hsrascon/Arduino-Electronic-Load-/README.md

# Arduino-Electronic-Load-
An electronic load in constant current mode using the Arduino
