hsrascon/Arduino-Electronic-Load-/Portfolio/4.-Presentation/Arduino Electronic Load_V05.pptx

## Arduino Electronic Load

Habid Rascon-Ramos

## Arduino Electronic Load Review

- Overview and Goals
- Hardware Development Process
- Final Product
- Results

## Overview

- Electronic Load
- Development tool
  - Power supply and battery testing
- Current commercial options
  - Too expensive and overpowered

## Goals

- Open source
- Cater to maker market
- Make it programmable using Arduino
- Deliverable: The load can maintain a 1A current draw for 1 hour at 5% accuracy

## Product Definition: Feature Block Diagram

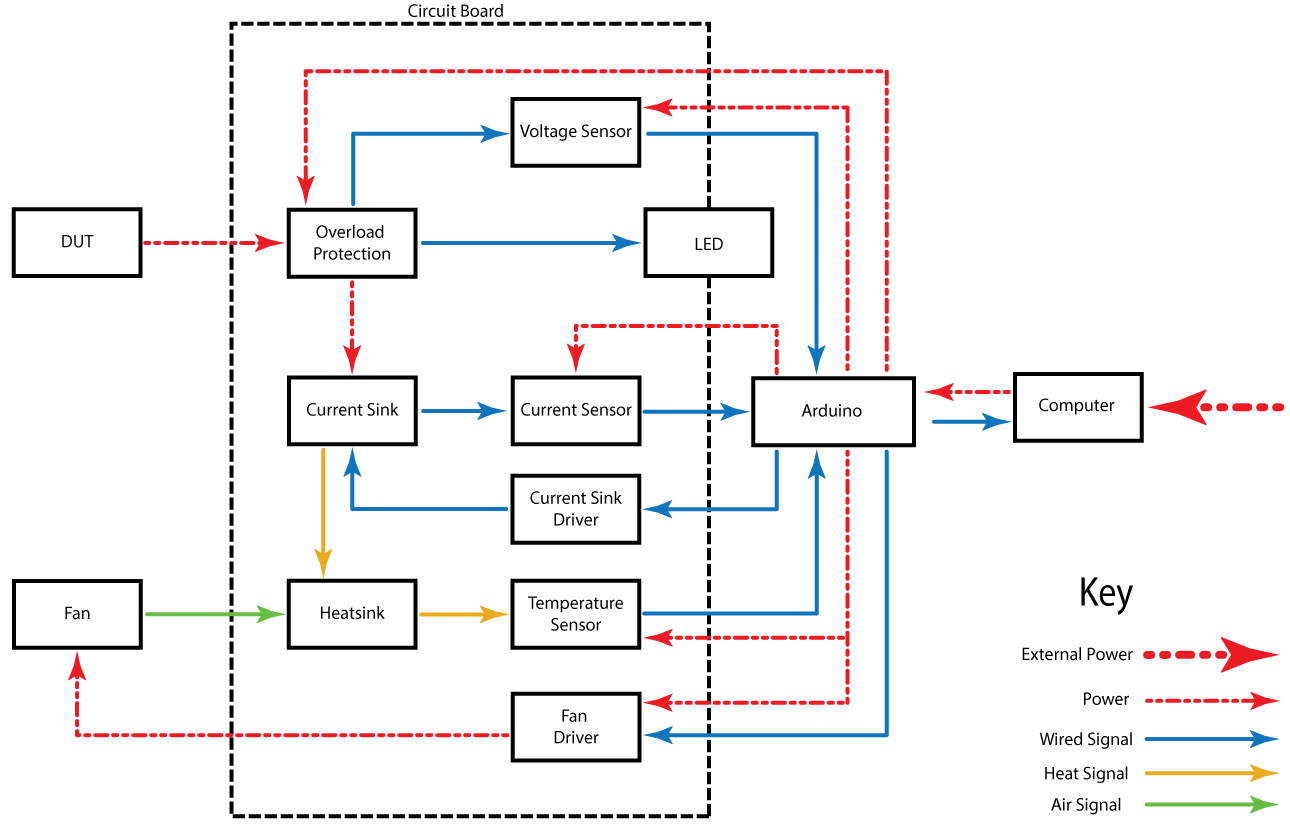
[picture p1: figure]

## Product Definition: State Machine Flow Diagram

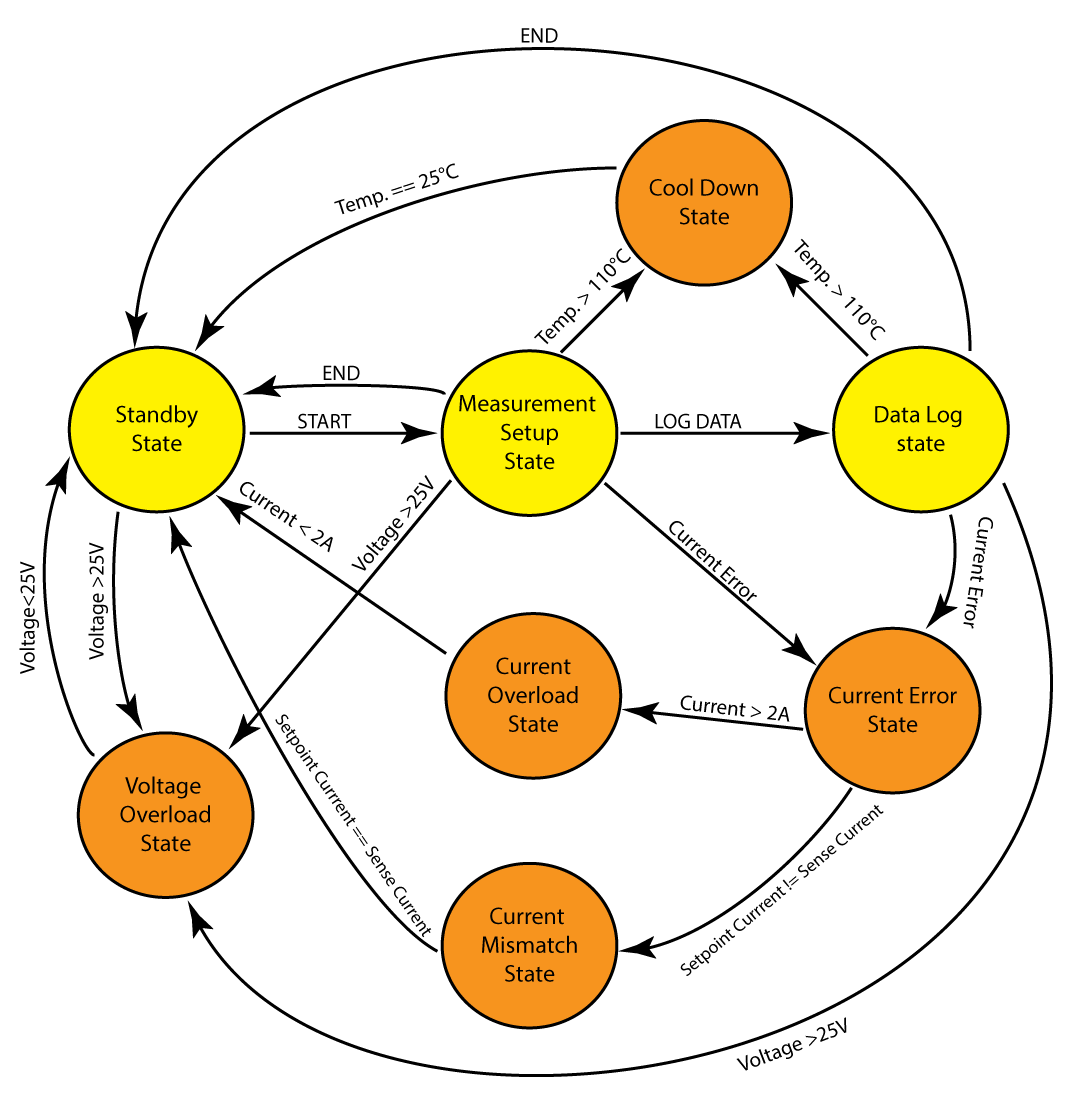
[picture p2: figure]

## Architecture: Hardware Block Diagram

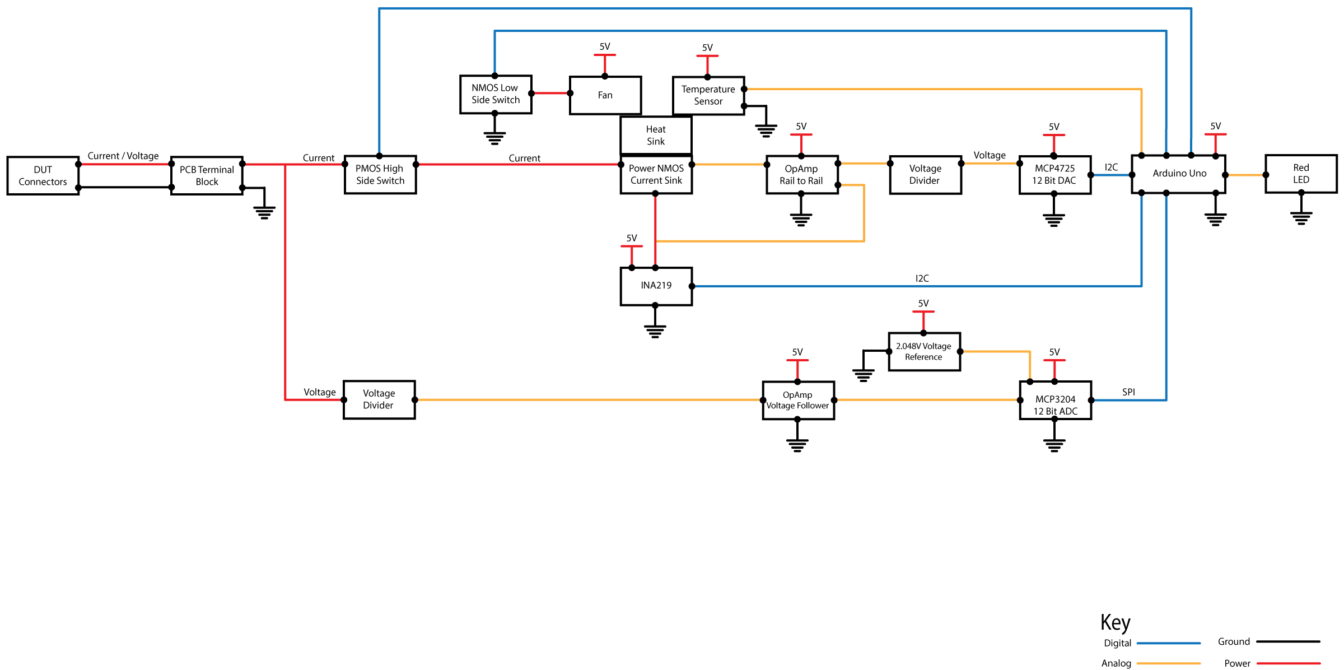
[picture p3: figure]

## Realization: PCB Schematic

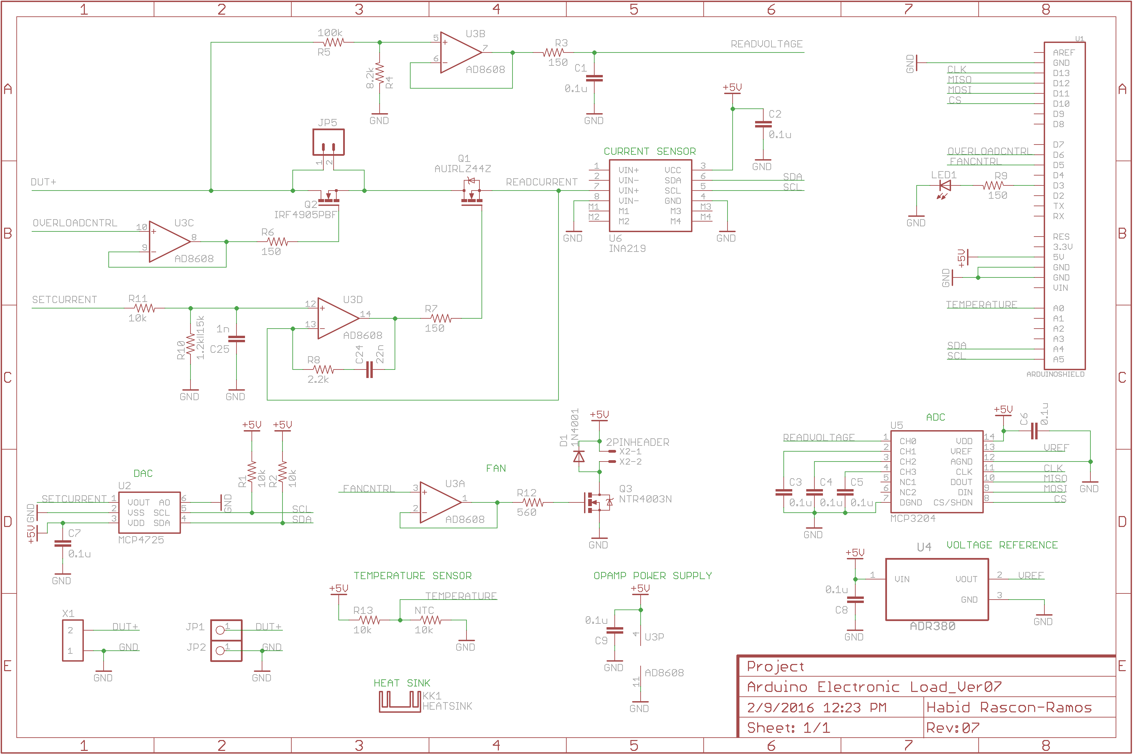
[picture p4: figure]

## Realization: PCB Layout

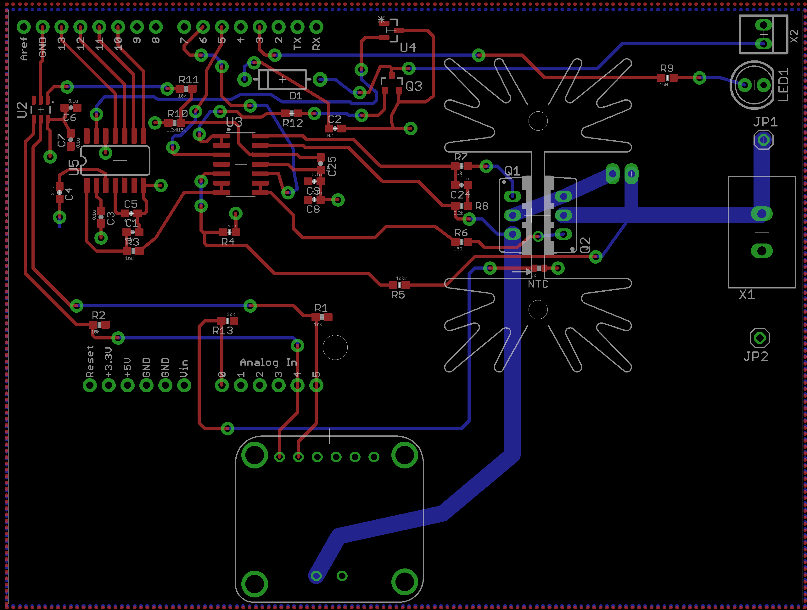
[picture p5: figure]

## Final Product: Hardware

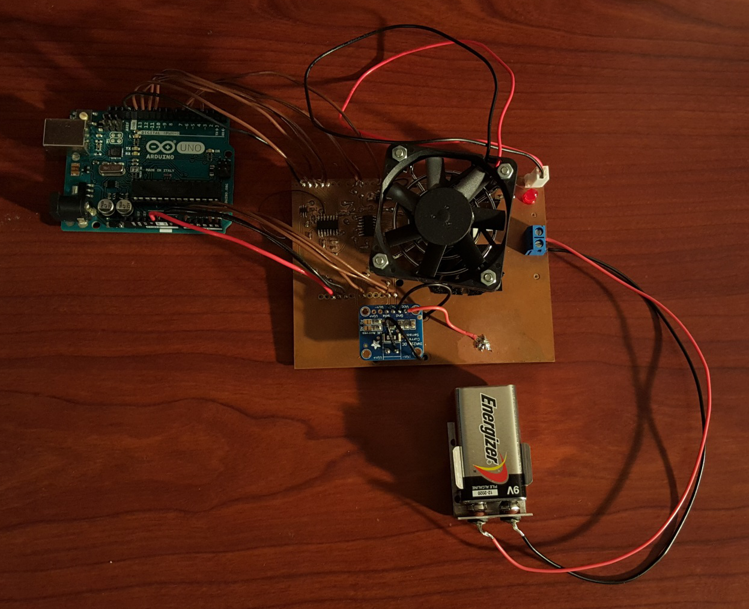
[picture p6: figure]

## Final Product: Software

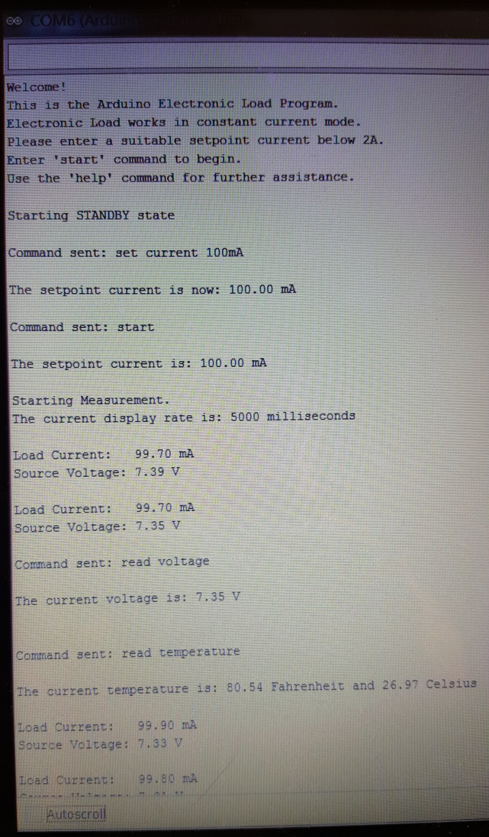
[picture p7: figure]

## Results: Constant Current Test

## Results: 9V Battery Test
