hsrascon/Arduino-Electronic-Load-/Portfolio/1.-Product-Definition/ArduinoELoad_FeatureDiagram_V07.pdf

## Key

Power

Wired Signal

External Power

## Version 07

## Arduino Electronic Load Feature Block Diagram

Heat Signal
Air Signal

Introduction:
This diagram shows the relationship between the dierent blocks that appear in the Feature List. The dashed line represents a device boundary. An interface will need to be dened for any signal that crosses the boundary. Blocks that touch the boundary are access able from the outside of the device

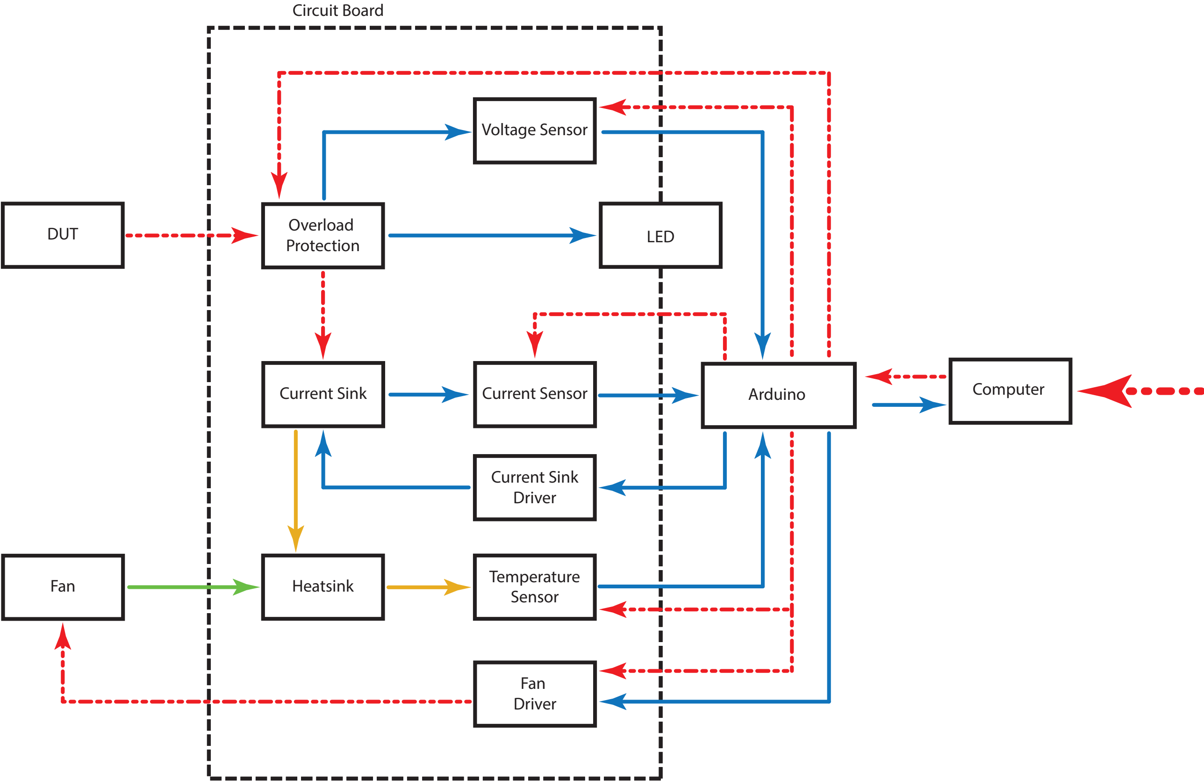
[picture p8: figure]
Voltage Sensor; Current Sensor; Arduino; Circuit Board; Current Sink Driver; Current Sink; Computer; Overload Protection; Temperature Sensor; DUT; LED; Heatsink; Fan Driver; Fan
