hsrascon/Arduino-Electronic-Load-/Portfolio/3.-Realization/ManufacturingPackage/ArduinoElectronicLoad_FullBOM.xlsx

Author: Habid Rascon-Ramos
Date: February 11, 2016
Project: Arduino Electronic Load
Version: 01
Qty | Value | Device | Package | Parts | Description | DESCRIPTION | MANUFACTURER | MFG_PART_NUMBER | PACKAGE | VENDOR | VENDOR_PART_NUM
9 | 0.1u | CAP0603-CAP | 0603-CAP | C1, C2, C3, C4, C5, C6, C7, C8, C9 | Capacitor | CAP CER 0.1UF 16V X7R 0603 | Murata Electronics North America | GRM188R71C104KA01D | 603 | Digi-Key | 490-1532-1-ND
1 | 1.1k | RESISTOR0603-RES | 0603-RES | R10 | Resistor | RES SMD 1.1K OHM 1% 1/10W 0603 | Yageo | RC0603FR-071K1L | 603 | Digi-Key | 311-1.10KHRCT-ND
1 | 100k | RESISTOR0603-RES | 0603-RES | R5 | Resistor | RES SMD 100K OHM 1% 1/10W 0603 | Yageo | RC0603FR-07100KL | 603 | Digi-Key | 311-100KHRCT-ND
1 | 10k | RESISTOR0402-RES | 0402-RES | NTC | Resistor | THERMISTOR 10K OHM NTC 0402 SMD | Murata Electronics North America | NCP15XH103F03RC | 402 | Digi-Key | 490-4801-1-ND
4 | 10k | RESISTOR0603-RES | 0603-RES | R1, R2, R11, R13 | Resistor | RES SMD 10K OHM 1% 1/10W 0603 | Yageo | RC0603FR-0710KL | 603 | Digi-Key | 311-10.0KHRCT-ND
4 | 150 | RESISTOR0603-RES | 0603-RES | R3, R6, R7, R9 | Resistor | RES SMD 150 OHM 1% 1/10W 0603 | Yageo | RC0603FR-07150RL | 603 | Digi-Key | 311-150HRCT-ND
1 | 1N4001 | DIODEPTH | DIODE-1N4001 | D1 | Diode | DIODE GEN PURP 50V 1A DO41 | Fairchild Semiconductor | 1N4001 | DO-41 | Digi-Key | 1N4001FSCT-ND
1 | 1n | CAP0603-CAP | 0603-CAP | C25 | Capacitor | CAP CER 1000PF 50V X7R 0603 | Murata Electronics North America | GRM188R71H102KA01D | 603 | Digi-Key | 490-1494-1-ND
1 | 2.2k | RESISTOR0603-RES | 0603-RES | R8 | Resistor | RES SMD 2.2K OHM 1% 1/10W 0603 | Yageo | RC0603FR-072K2L | 603 | Digi-Key | 311-2.20KHRCT-ND
1 | 22232021 | CON-MOLEX_22-23-2021 | CON-MOLEX_22-23-2021 | X2 | .100 (2.54mm) Center Header - 2 Pin" | CONN HEADER 2POS .100 VERT TIN | Molex, LLC | 22232021 | N/A | Digi-Key | WM4200-ND
1 | 22n | CAP0603-CAP | 0603-CAP | C24 | Capacitor | CAP CER 0.022UF 16V X7R 0603 | Murata Electronics North America | GRM188R71C223KA01D | 603 | Digi-Key | 490-1527-1-ND
1 | 560 | RESISTOR0603-RES | 0603-RES | R12 | Resistor | RES SMD 560 OHM 1% 1/10W 0603 | Yageo | RC0603FR-07560RL | 603 | Digi-Key | 311-560HRCT-ND
1 | 8.2k | RESISTOR0603-RES | 0603-RES | R4 | Resistor | RES SMD 8.2K OHM 1% 1/10W 0603 | Yageo | RC0603FR-078K2L | 603 | Digi-Key | 311-8.20KHRCT-ND
1 | 961102-6404-AR | M02 | 1X02_LONGPADS | JP5 | Header 2 | CONN HEADER VERT SGL 2POS GOLD | 3M | 961102-6404-AR | N/A | Digi-Key | 3M9447-ND
1 | AD8608 | AD8608R | SO14 | U3 | Precision, Low Noise, CMOS, Rail-to-Rail, Input/Output Operational Amplifiers | IC OPAMP GP 10MHZ RRO 14TSSOP | Analog Devices Inc. | AD8608ARUZ-REEL | 14-TSSOP | Digi-Key | AD8608ARUZ-REELTR-ND
1 | ADR380 | ADR380ARTZ-REEL7 | SOT95P237X112-3N | U4 | Precision Low Drift 2.048 V/2.500 V SOT-23 Voltage Reference | IC VREF SERIES 2.048V SOT23-3 | Analog Devices Inc. | ADR380ARTZ-REEL7 | SOT-23-3 | Digi-Key | ADR380ARTZ-REEL7CT-ND
1 | AUIRLZ44Z | IRLZ44Z | TO220BV_1 | Q1 | N-Channel HEXFET® Power MOSFET Logic Level | MOSFET Transistor, N Channel, 51 A, 55 V, TO-220AB | INTERNATIONAL RECTIFIER | AUIRLZ44Z | TO-220AB | Newark | 54T9019
1 | INA219 | INA219 | INA219 | U6 |  | BREAKOUT INA219 DC SENS 26V 3.2A | Adafruit Industries LLC | 904 | N/A | Digi-Key | 1528-1168-ND
1 | IRF4905PBF | PMOSFET_NTO220BV | TO220BV | Q2 | Power MOSFET N-Channel | MOSFET P-CH 55V 74A TO-220AB | Infineon Technologies Americas Corp. | IRF4905PBF | TO-220AB | Digi-Key | IRF4905PBF-ND
1 | LTL2R3KRD-EM | LED5MM | LED5MM | LED1 | LEDs | LED RED DIFF 5MM ROUND T/H | Lite-On Inc. | LTL2R3KRD-EM | Radial | Digi-Key | 160-1853-ND
1 | MCP3204 | MCP3204CRZ | SOIC-14 | U5 | IC ADC 12BIT 2.7V 4CH SPI 14SOIC | IC ADC 12BIT 2.7V 4CH SPI 14SOIC | Microchip Technology | MCP3204-CI/SL | 14-SOIC | Digi-Key | MCP3204-CI/SL-ND
1 | MCP4725 | MCP4725SOT-23 | SOT23-6 | U2 | Microchip 12-bit I2C DAC, SOT23-6 | IC DAC 12BIT W/I2C SOT23A-6 | Microchip Technology | MCP4725A0T-E/CH | SOT-23-6 | Digi-Key | MCP4725A0T-E/CHCT-ND
1 | NTR4003N | MOSFET-NCHANNELAO3404A | SOT23-3 | Q3 | Common NMOSFET Parts | MOSFET N-CH 30V 500MA SOT-23 | ON Semiconductor | NTR4003NT1G | SOT-23-3 | Digi-Key | NTR4003NT1GOSCT-ND
1 | OSTTC022162 | ED350/2 | ED350/2 | X1 | ED350/X (5.0 mm) TERMINAL BLOCK 5MM VERT 2POS PCB | TERM BLOCK 5.08MM VERT 2POS PCB | On Shore Technology Inc. | OSTTC022162 | N/A | Digi-Key | ED2609-ND
1 | SK 129 25,4 STS | HEATSINK_SK129 | HEATSINK_SK129-HOLE | KK1 | HEATSINK manufacturer Fischer/distributor Buerklin | HEAT SINK, EXTRUDED, PCB MOUNT | FISCHER ELEKTRONIK | SK 129 25,4 STS | N/A | Newark | 74M4513
1 | EB50100S2-0000-999 | N/A | N/A | N/A | N/A | FAN, 50X50X10MM, 5VDC | SUNON | EB50100S2-0000-999 | N/A | Newark | 58T4647
