hsrascon/Arduino-Electronic-Load-/Portfolio/2.-Architecture/ArduinoELoadHardwareBlockDiagram_V06.pdf

# Arduino Electronic Load Hardware Block Diagram V06

## Introduction:

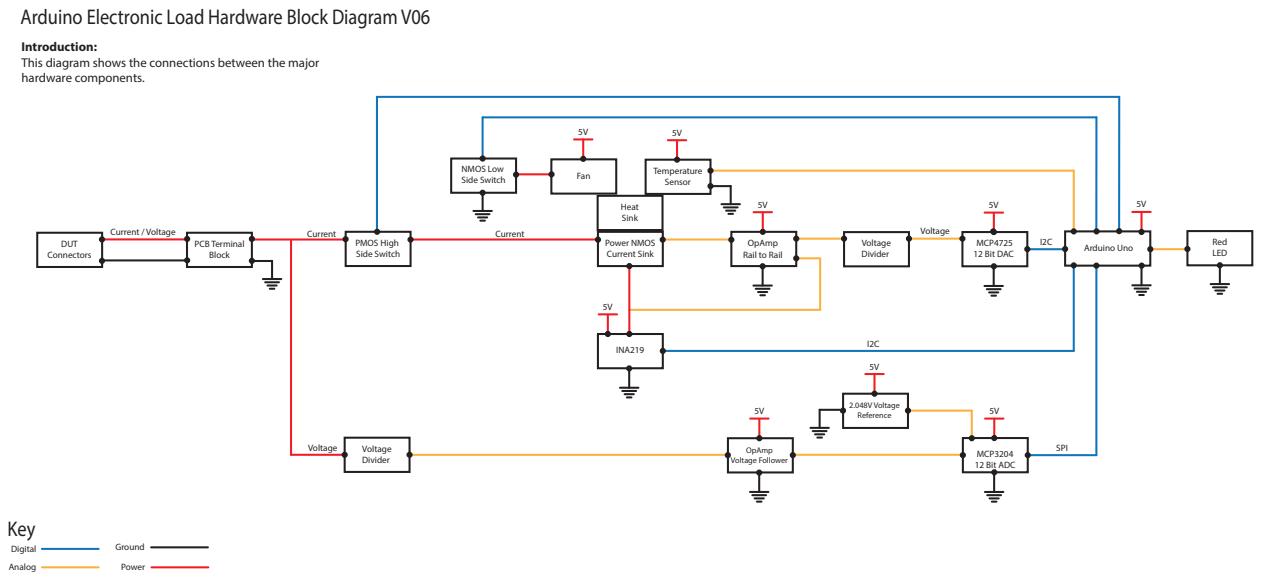
[picture p9: page 1]
Red LED; PCB Terminal Block; Key; Digital; Power; Ground; Analog; DUT Connectors; Current / Voltage; Heat Sink; Temperature Sensor; Current; Voltage; Voltage Divider; MCP4725 12 Bit DAC; OpAmp Voltage Follower; Fan; NMOS Low Side Switch; PMOS High Side Switch; Power NMOS Current Sink; INA219; Arduino Uno; MCP3204 12 Bit ADC; 2.048V Voltage Reference; SPI

This diagram shows the connections between the major
hardware components.

OpAmp
Rail to Rail
