hsrascon/Arduino-Electronic-Load-/Portfolio/1.-Product-Definition/ArduinoELoad_StateMachine_V01.pdf

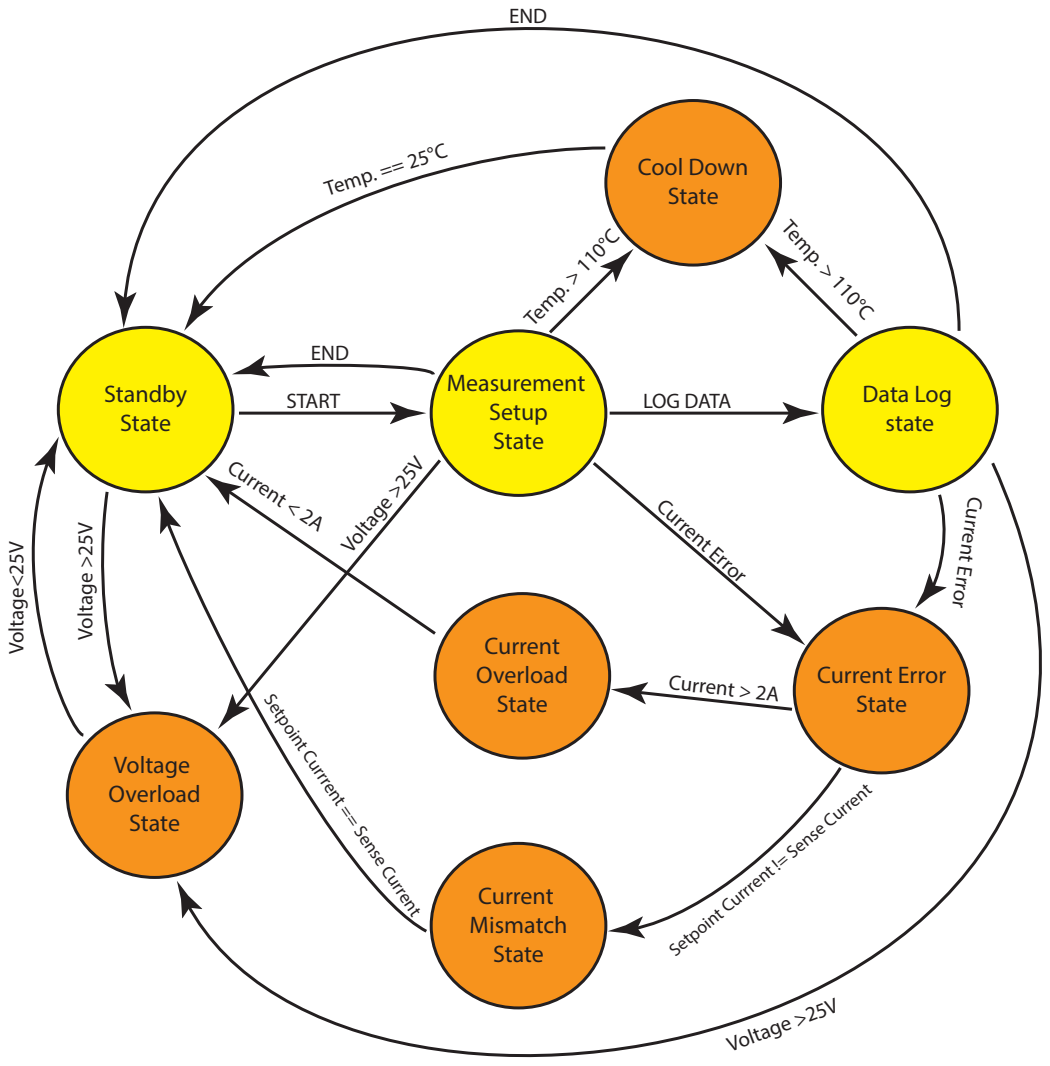
[picture p10: page 1]
Standby State; Measurement Setup State; Data Log state; Voltage Overload State; Current Error State; Cool Down State; Current Mismatch State; Current Overload State; START; Voltage >25V; Current Error; Temp. > 110°C; LOG DATA; END; Voltage<25V; Current < 2A; Current > 2A; Temp. == 25°C

Setpoint Currrent == Sense Current

Setpoint Currrent != Sense Current
