hsrascon/Arduino-Electronic-Load-/Portfolio/3.-Realization/Board/ArduinoELoad_Layout_V08.pdf

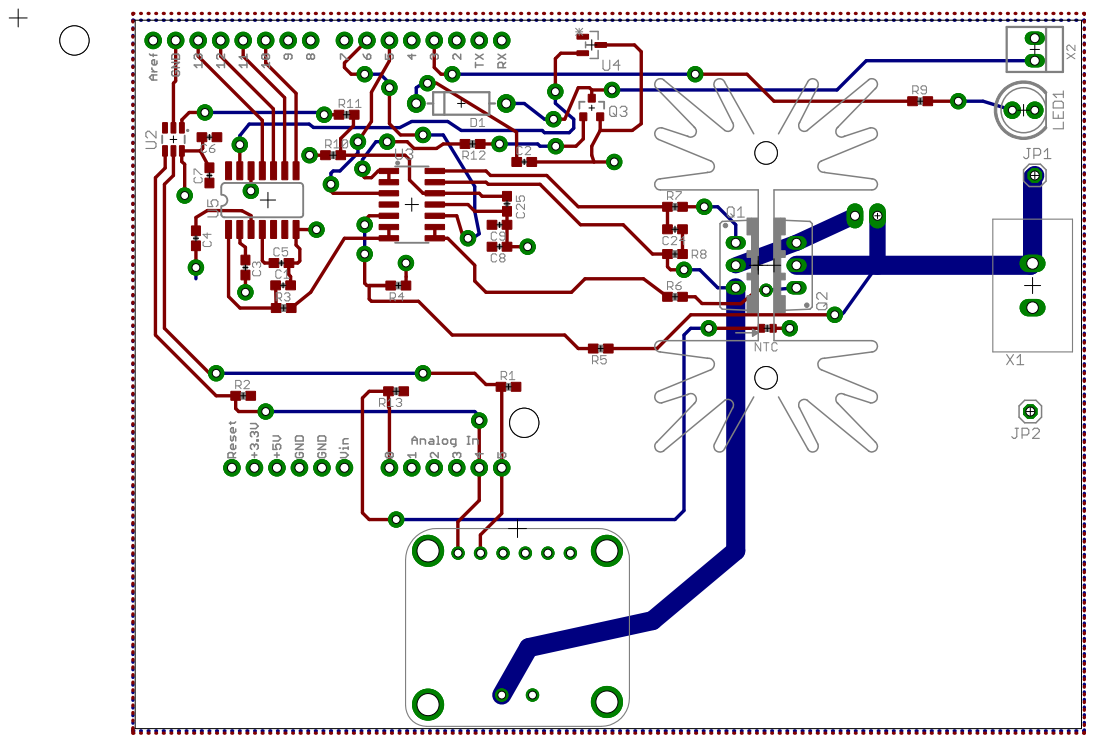
[picture p11: page 1]
