hsrascon/Arduino-Electronic-Load-/Portfolio/3.-Realization/Board/ArduinoELoad_Schematic_V08.pdf

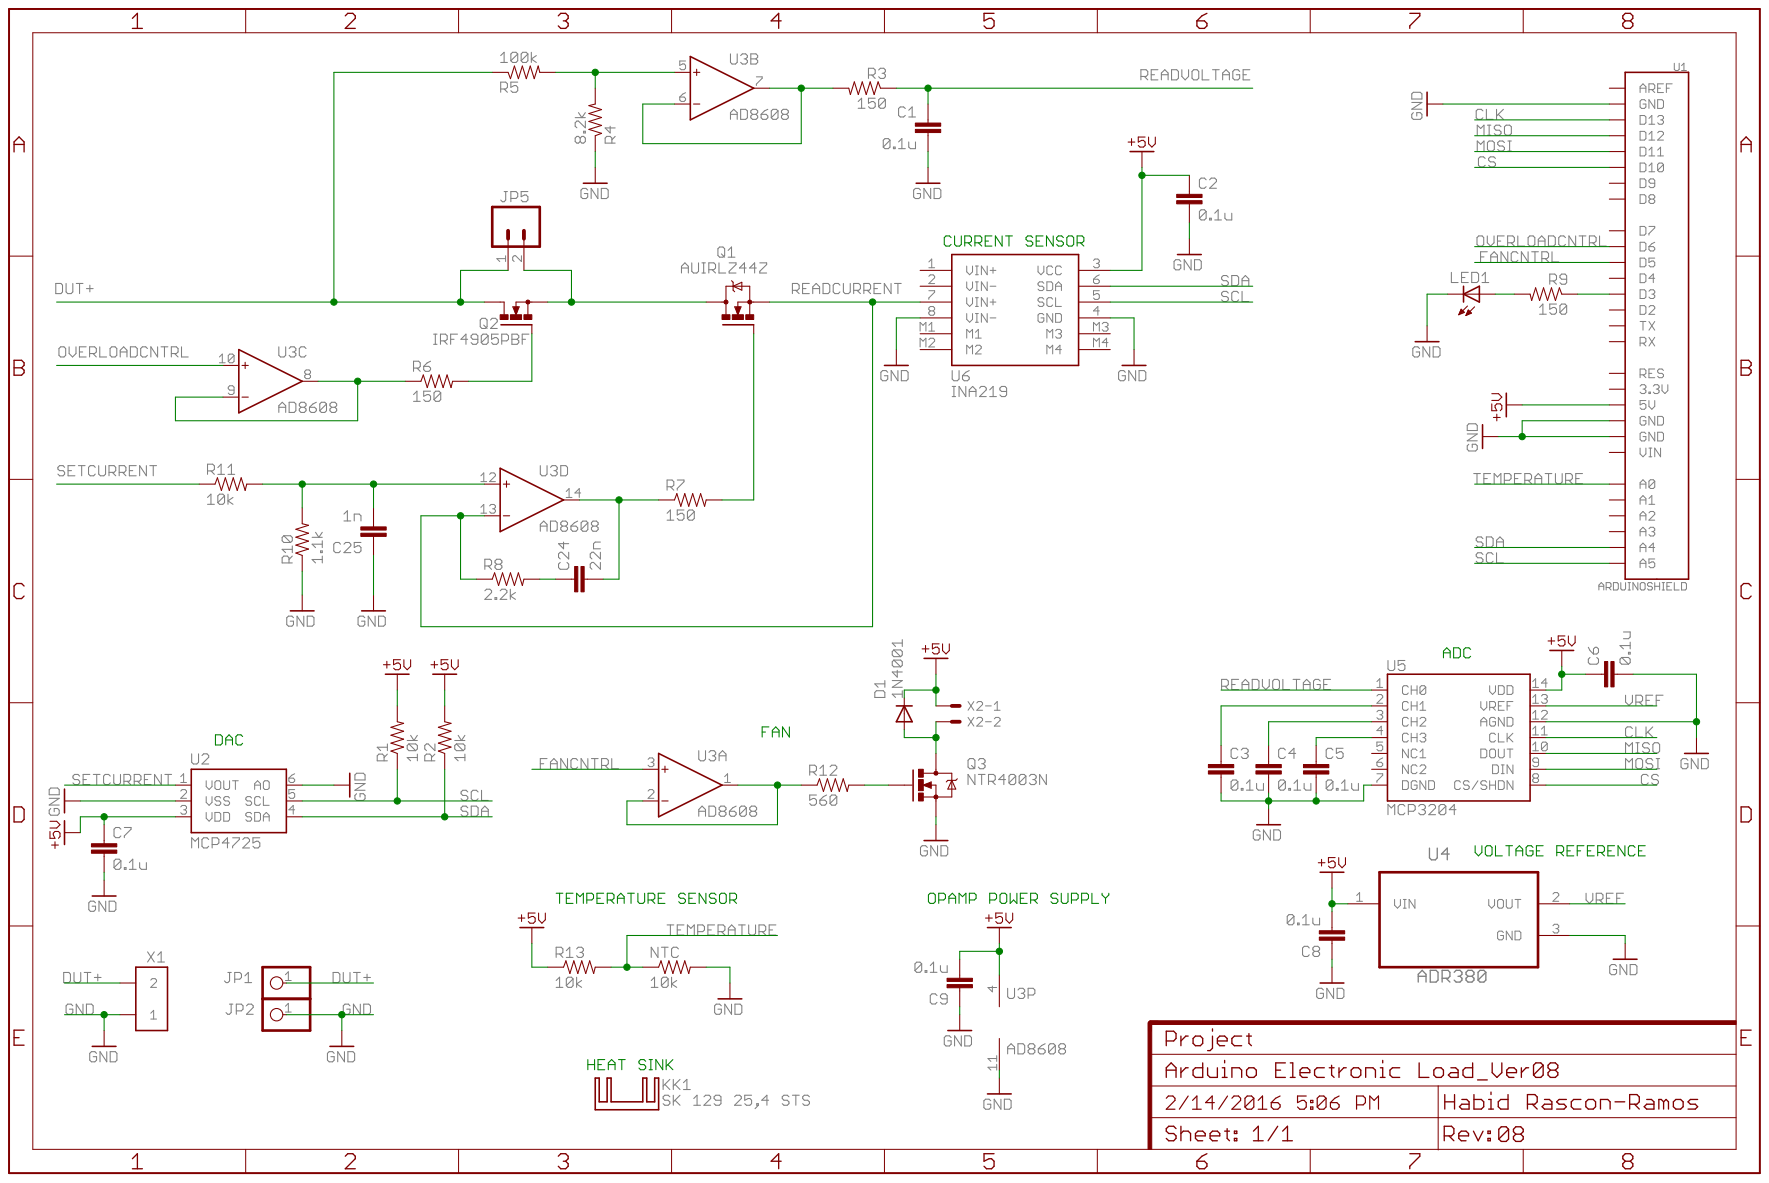
[picture p12: page 1]
